warmech/m0110-to-lisa-keyboard-adapter/docs/schematics/adapter_schematics.pdf

LISA_DATA | LISA_DATA

GND

GND/VCC
GND
M0110_CLOCK

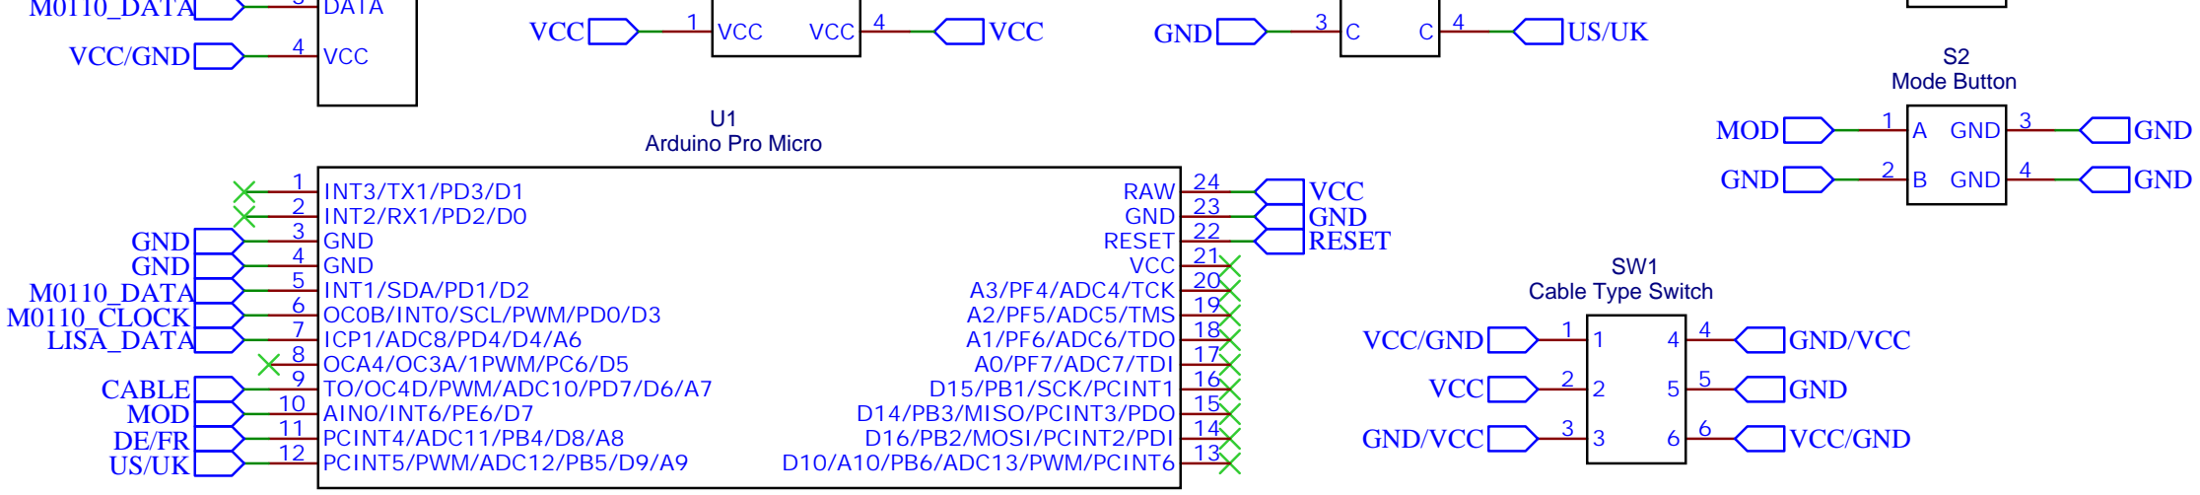
[picture p4: figure]
M0110_CLOCK; M0110_DATA; LISA_DATA; VCC; VCC/GND; VCC GND; GND; RESET; VCC 4; VCC 1; Arduino Pro Micro; INT3/TX1/PD3/D1 1 INT2/RX1/PD2/D0 2 GND 3 GND 4 INT1/SDA/PD1/D2 5 OC0B/INT0/SCL/PWM/PD0/D3 6 ICP1/ADC8/PD4/D4/A6 7 OCA4/OC3A/1PWM/PC6/D5 8 TO/OC4D/PWM/ADC10/PD7/D6/A7 9 AIN0/INT6/PE6/D7 10 PCINT4/ADC11/PB4/D8/A8 11; PCINT5/PWM/ADC12/PB5/D9/A9 12; D10/A10/PB6/ADC13/PWM/PCINT6; 13 D16/PB2/MOSI/PCINT2/PDI; 14 D14/PB3/MISO/PCINT3/PDO; 15 D15/PB1/SCK/PCINT1; 16 A0/PF7/ADC7/TDI; 17 A1/PF6/ADC6/TDO; 18 A2/PF5/ADC5/TMS; 19 A3/PF4/ADC4/TCK; 20 VCC; 21 RESET; 22 GND; 23 RAW; MOD; Mode Button; CABLE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

M0110_DATA

RESET | GND

Reset Button

S1

A

1

B

2

GND | 3
GND | 4

Mac Plus Keyboard Connector

J2

GND 1

CLOCK 2

DATA 3

Lisa Keyboard Connector

J1

DAT 2

GND 3

DAT | 5
GND | 6
GND | GND

GND
GND

CABLE
DE/FR

Settings DIP Switch

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
