warmech/m0110-to-lisa-keyboard-adapter/docs/images/pcb_01.png

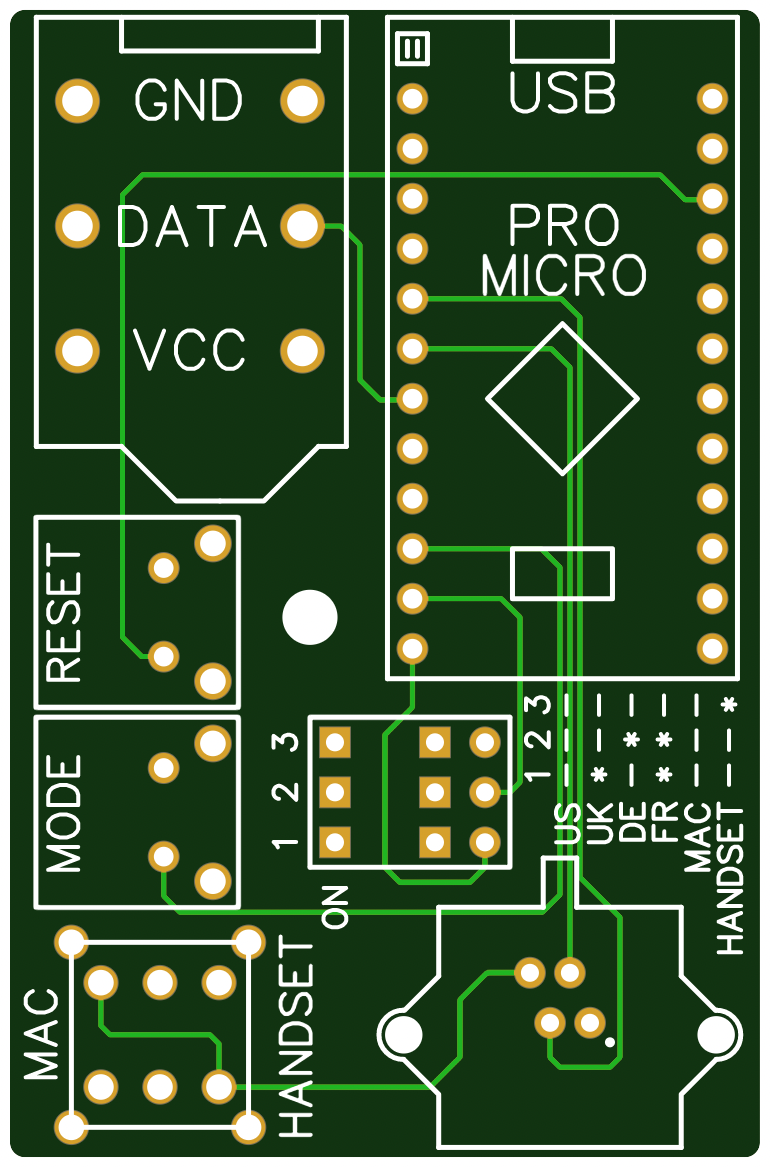
docs/images/pcb_01.png
