warmech/m0110-to-lisa-keyboard-adapter/(threads)

Thread 1 (2023-10-29):

Keys T and Y are swapped using an M0110A

RolandJuno, 2023-10-29:
Thanks so much for this project! I'm planning to incorporate it into a larger board for the Lisa that breaks out floppy and power functions.

It's working pretty well so far, except the T and Y keys seem swapped? I've attempted to change the code but I'm not sure which places to change.

Also, is it normal in the keyboard test mode for some keys to not have a key pressed event? In this example, the A key doesn't register a press, only a release.

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

There also seems to be phantom keys on some NumPad keys? In this example, I'm pressing and releasing Clear, =, /, and * but it registers releases of Down and Shift as well.

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

Thanks!

warmech, 2023-11-15:
Heya! Glad you've been able to get some use out of this project! I just found your Mastodon posts this morning about assembling a Lisa from scratch - solid work and congratulations on getting everything up and running! And fantastic work on your breakout board; I'd been kicking around the idea of designing something like that (and I think Alex had as well), but just have not had the time I'd like to dedicate to it. Thank you for taking the time and effort to put that together.

As for the issues you've run into, I'll take a look later in the week or this weekend as I have time. The T/Y keys thing is new to me but is hopefully a quick fix. I did run into some weird keypress issues during development of the diagnostic section, but they were ironed out by the time I published everything. That might take a little longer to figure out. The NumPad issues are... possibly unavoidable. I can't recall if I noted this in the readme, but the Lisa keyboards all share one really stupid trait - they send the same keycode for some of the NumPad keys as they do for some Shift+key combos. As far as I'm aware there's not really a way around this, but it's been long enough that I could probably look at this with fresh eyes and maybe come up with a solution. I assumed that this would be enough of an edge case that most (if not all) folks would probably not run into it but, as you have demonstrated, that was a crappy assumption on my part, lol.

RolandJuno, 2023-11-15:
Hey thanks for the kind words! I've temporarily worked around the issue by putting in a crude hack to intercept the T and Y keys (upper + lower case) in m0110.cpp by modifying raw2scan as follows:

```
uint8_t raw2scan(uint8_t raw)
{
    // Hack to swap the T and Y keys (by Paul Rickards) Oct 29, 2023
    switch (raw) {
      case 0x23:
        return 0x10;
        break;
      case 0xA3:
        return 0x90;
        break;
      case 0x21:
        return 0x11;
        break;
      case 0xA1:
        return 0x91;
        break;
    }
    return (raw == M0110_NULL) ? M0110_NULL : ((raw == M0110_ERROR) ? M0110_ERROR : (((raw&0x80) | ((raw & 0x7F) >> 1))));
}
```

It's a hack but it works for now. As for the ghost keys, it doesn't seem to be an issue in using the system. It appears it just ignores those extra keys.

Thanks!
